nirmalshah123/SoC-estimation-of-LiFePo4/BOM.csv

ID | Name | Designator | Footprint | Quantity | Manufacturer Part
1 | 22uF | C2,C7 | CAP-TH_BD5.0-P2.00-D0.8-FD | 2 | 22uF 50V 5*11
2 | 10uF | C3,C5,C9 | CAP-TH_BD6.3-P2.50-D1.0-FD | 3 | 10uf/100V
3 | 1758018 | CN2,CN3,CN4,CN6 | CONN-TH_P5.08_1758018 | 4 | 1758018
4 | 1.8kΩ | R2,R5,R6 | RES-TH_BD2.3-L6.5-P10.50-D0.5 | 3 | MF1/4W-1KΩ±1%T52
5 | 8.2kΩ | R3,R4,R7 | RES-TH_BD2.3-L6.5-P10.50-D0.5 | 3 | MF1/4W-1KΩ±1%T52
6 | 10kΩ | R9 | RES-TH_BD2.3-L6.5-P10.50-D0.5 | 1 | MF1/4W-1KΩ±1%T52
7 | 10k | R10 | RES-TH_BD2.3-L6.5-P10.50-D0.5 | 1 | MF1/4W-1KΩ±1%T52
8 | Precision potentiometer 3296W/50ohm | R8 | RES-ADJ-TH_3296W | 1 | Precision potentiometer 3296W/50ohm
9 | Momentary-Switch-SPST-6MM | S1 | MOMENTARY_SWITCH | 1
10 | ATMEGA328P-PU | U1 | DIP-28_L34.6-W7.3-P2.54-LS10.2-BL | 1 | ATMEGA328P-PU
11 | BERG_STRIP_20 | U6 | BERG_STRIP_20 | 1
12 | LM7805CT | U13 | TO-220-3_L10.0-W4.5-P2.54-L | 1 | LM7805CT
13 | BERG 1 PIN | U3,U4,U5,U7,U8,U9,U2,U11,U12,U10 | BERG 1 PIN | 10
14 | 16 MHz | CRYSTAL1 | HC49S | 1
