nirmalshah123/SoC-estimation-of-LiFePo4/Schematic.pdf

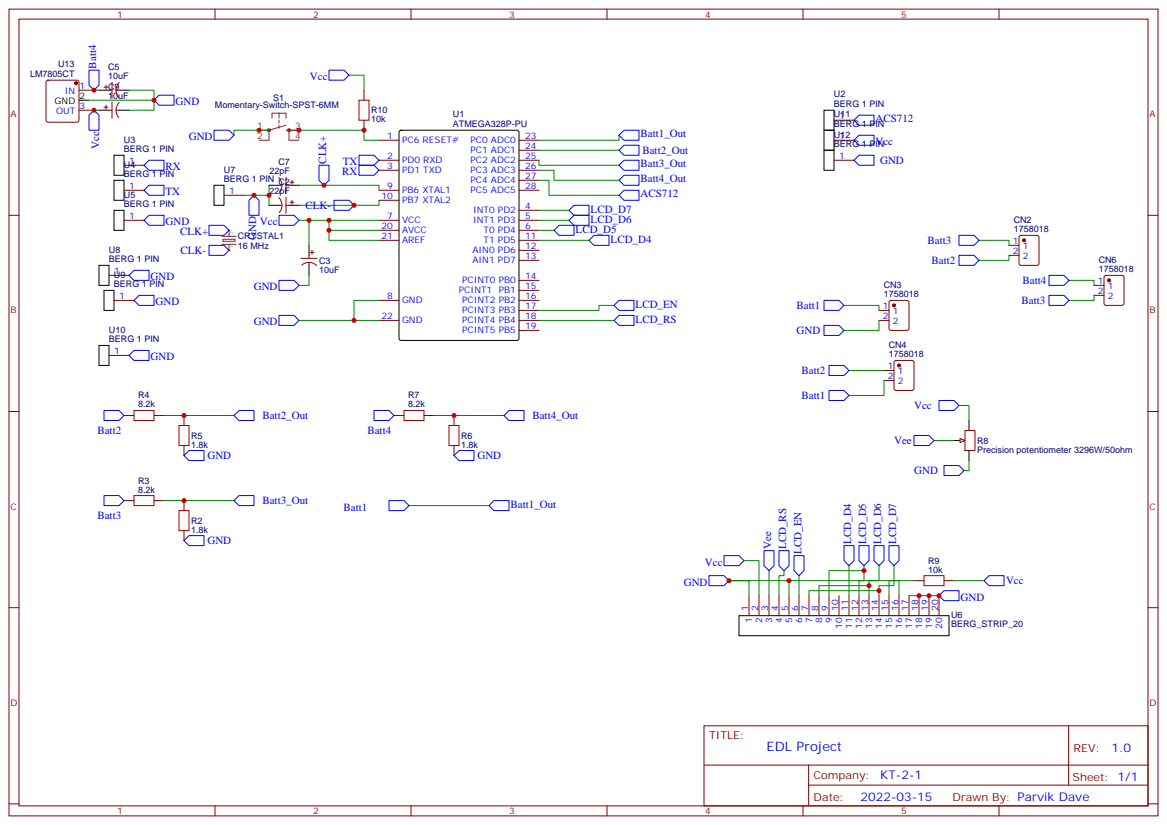
[picture p8: page 1]

Drawn By: Parvik Dave
