nirmalshah123/SoC-estimation-of-LiFePo4/PCB.pdf

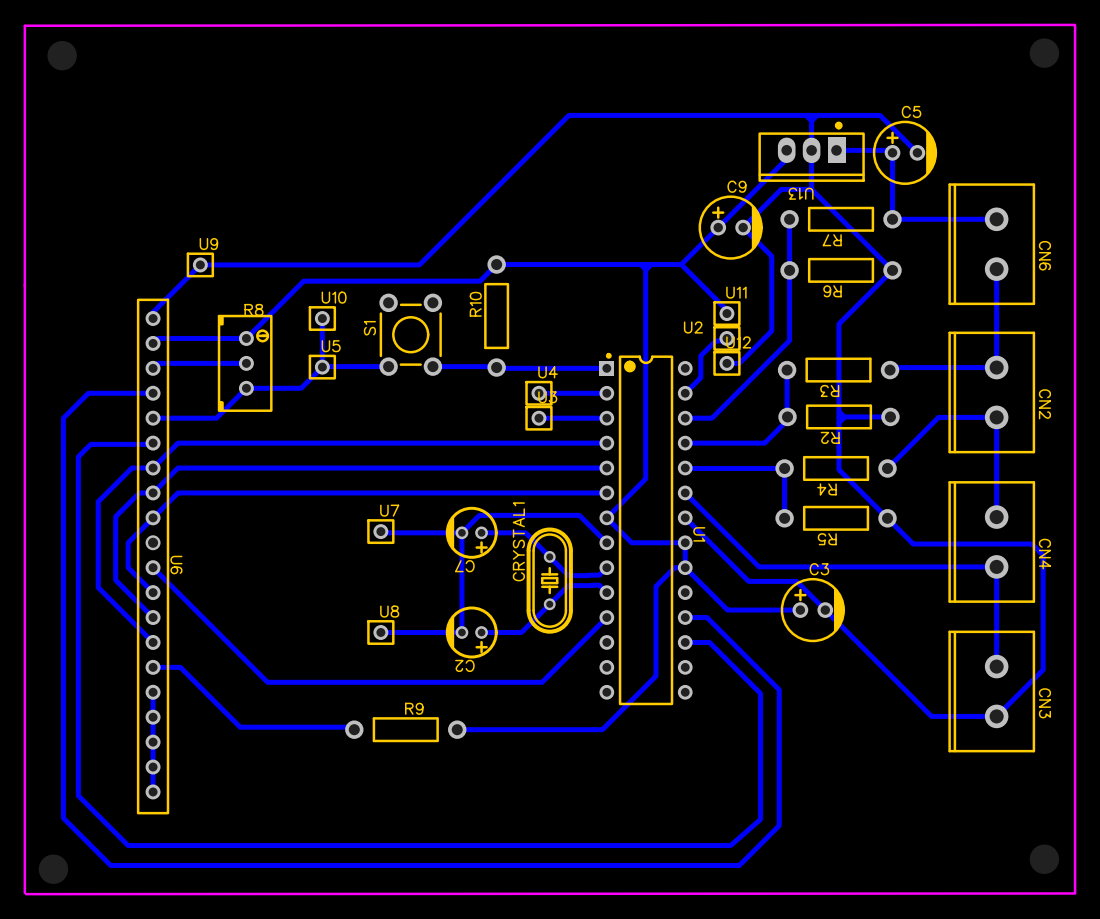
[picture p9: page 1]
